maksvet/F2D-RC-shutoff/README.md

# F2D-RC-shutoff
Control line combat F2D RC shutoff
2.4 shutoff rev 0.00
drive the input to an LP4 module to use in F2D shutoff on demand application.
Hold down button during binding.
press button to activate shut off
fail safe will shut off
If the servo motion is backwards then jumper from 8 to 9 and rebind
RF module connects to tx0
