maksvet/F2D-RC-shutoff/Parts-list-transmitter.pdf

# Transmitter/ Передатчик

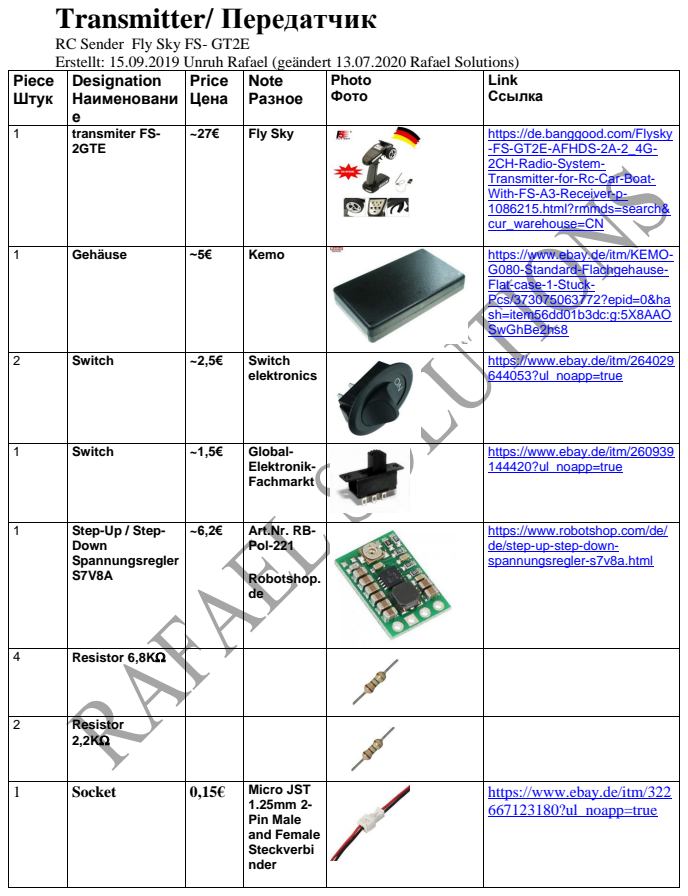
[picture p9: page 1]

RC Sender Fly Sky FS- GT2E
Erstellt: 15.09.2019 Unruh Rafael (geändert 13.07.2020 Rafael Solutions)

Piece Штук | Designation Наименовани е | Price Цена | Note Разное | Photo Фото | Link Ссылка

1 | transmiter FS-2GTE | ~27€ | Fly Sky | | https://de.banggood.com/Flysky-FS-GT2E-AFHDS-2A-2_4G-2CH-Radio-System-Transmitter-for-Rc-Car-Boat-With-FS-A3-Receiver-p-1086215.html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 (https://de.banggood.com/Flysky-FS-GT2E-AFHDS-2A-2_4G-2CH-Radio-System-Transmitter-for-Rc-Car-Boat-With-FS-A3-Receiver-p-1086215.html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)

1 | Gehäuse | ~5€ | Kemo | | https://www.ebay.de/itm/KEMO-G080-Standard-Flachgehause-Flat-case-1-Stuck-Pcs/373075063772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 SwGhBe2hs8 (https://www.ebay.de/itm/KEMO-G080-Standard-Flachgehause-Flat-case-1-Stuck-Pcs/373075063772?epid=0)

2 | Switch | ~2,5€ | Switch elektronics | | https://www.ebay.de/itm/264029644053?ul_noapp=true (https://www.ebay.de/itm/264029644053?ul_noapp=true)

1 | Switch | ~1,5€ | Global-Elektronik-Fachmarkt | | https://www.ebay.de/itm/260939144420?ul_noapp=true (https://www.ebay.de/itm/260939144420?ul_noapp=true)

1 | Step-Up / Step-Down Spannungsregler S7V8A | ~6,2€ | Art.Nr. RB-Pol-221 Robotshop. de | | https://www.robotshop.com/de/de/step-up-step-down-spannungsregler-s7v8a.html (https://www.robotshop.com/de/de/step-up-step-down-spannungsregler-s7v8a.html)

4 | Resistor 6,8KΩ

2 | Resistor 2,2KΩ

1 | Socket | 0,15€ | Micro JST 1.25mm 2-Pin Male and Female Steckverbi nder | | https://www.ebay.de/itm/322667123180?ul_noapp=true (https://www.ebay.de/itm/322667123180?ul_noapp=true)

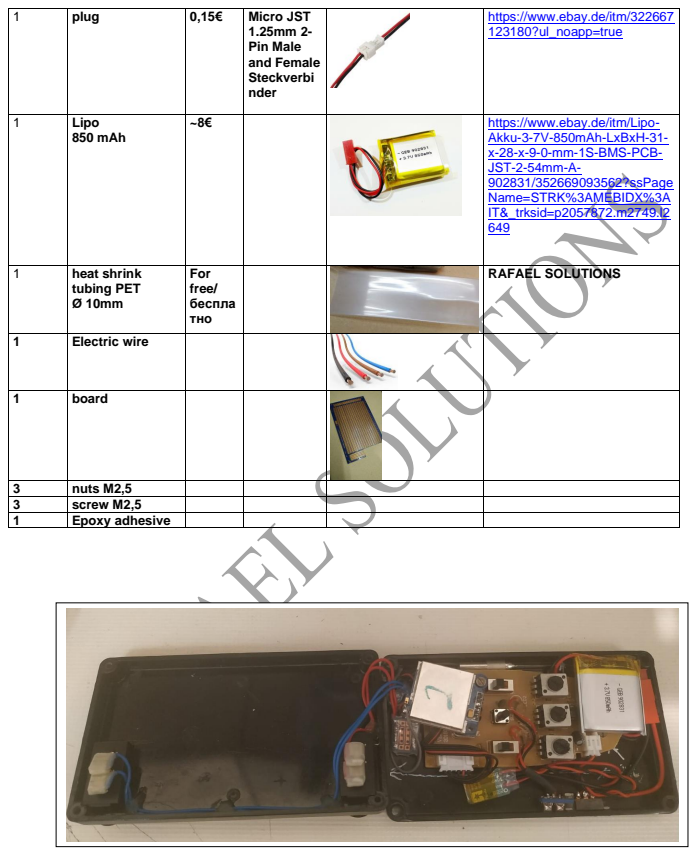
[picture p10: page 2]

1 | plug | 0,15€ | Micro JST 1.25mm 2-Pin Male and Female Steckverbi nder | https://www.ebay.de/itm/322667123180?ul_noapp=true (https://www.ebay.de/itm/322667123180?ul_noapp=true)

1 | Lipo 850 mAh | ~8€ | | https://www.ebay.de/itm/Lipo-Akku-3-7V-850mAh-LxBxH-31-x-28-x-9-0-mm-1S-BMS-PCB-JST-2-54mm-A-902831/352669093562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 649 (https://www.ebay.de/itm/Lipo-Akku-3-7V-850mAh-LxBxH-31-x-28-x-9-0-mm-1S-BMS-PCB-JST-2-54mm-A-902831/352669093562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)

1 | heat shrink tubing PET Ø 10mm | For free/ беспла тно | | RAFAEL SOLUTIONS

1 Electric wire

1 board

3 nuts M2,5
3 screw M2,5
1 Epoxy adhesive

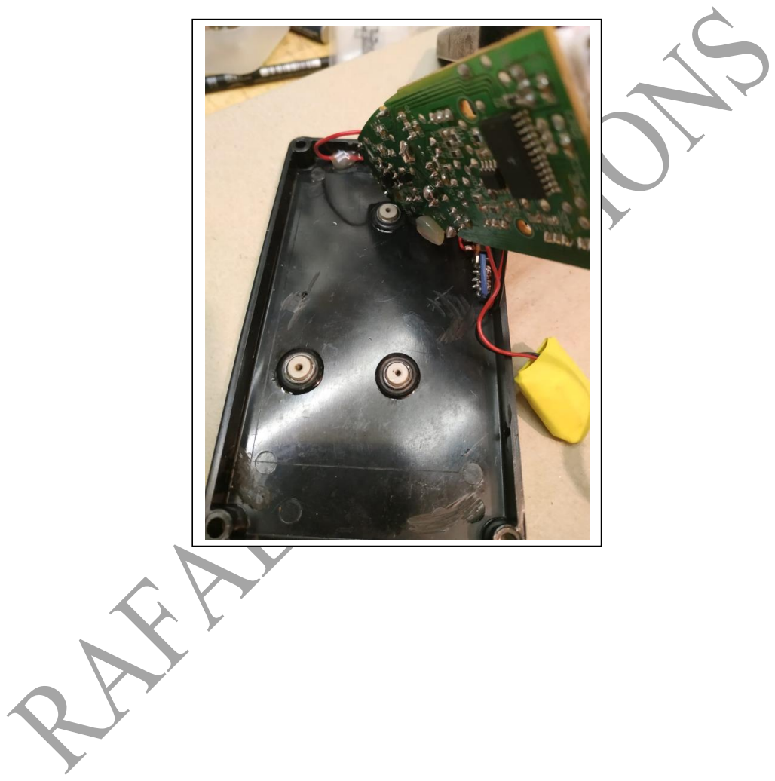
[picture p11: page 3]

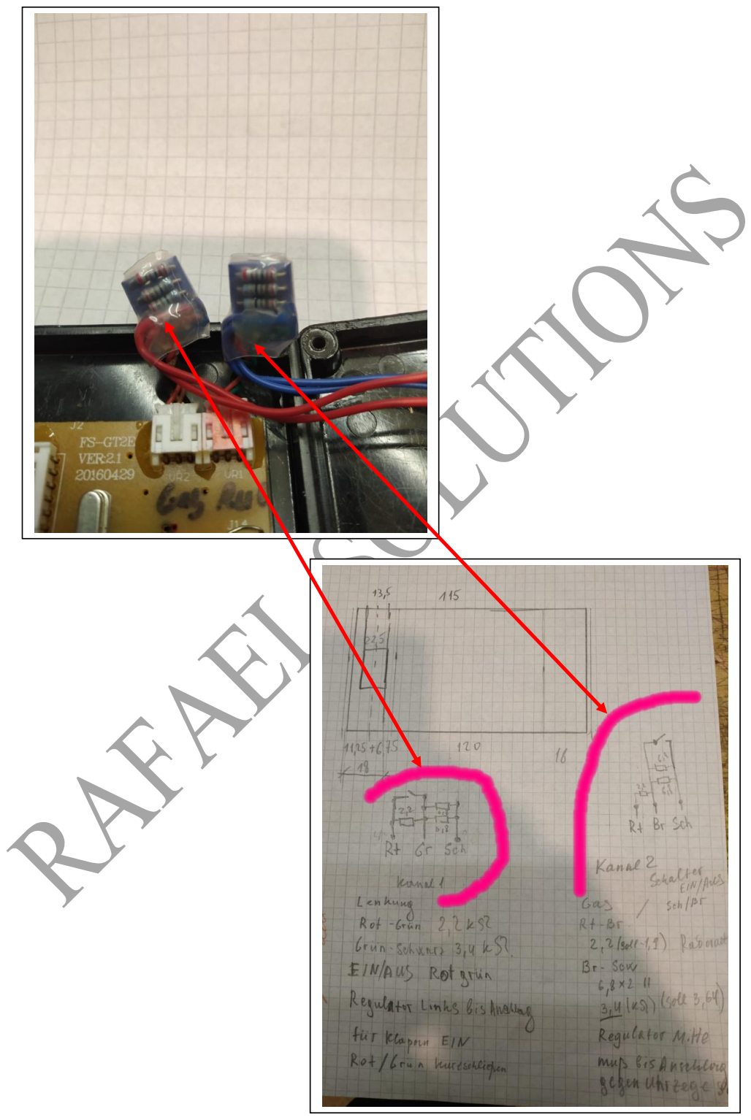
[picture p12: page 4]

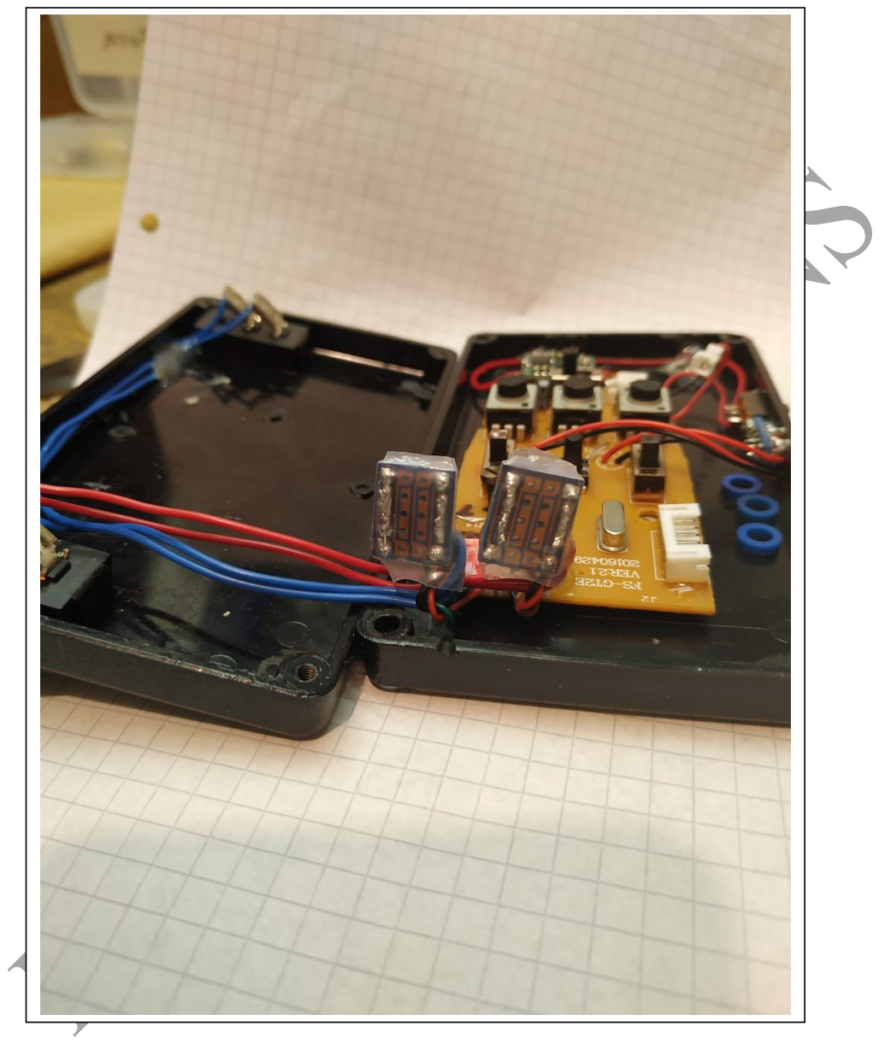
[picture p13: page 5]

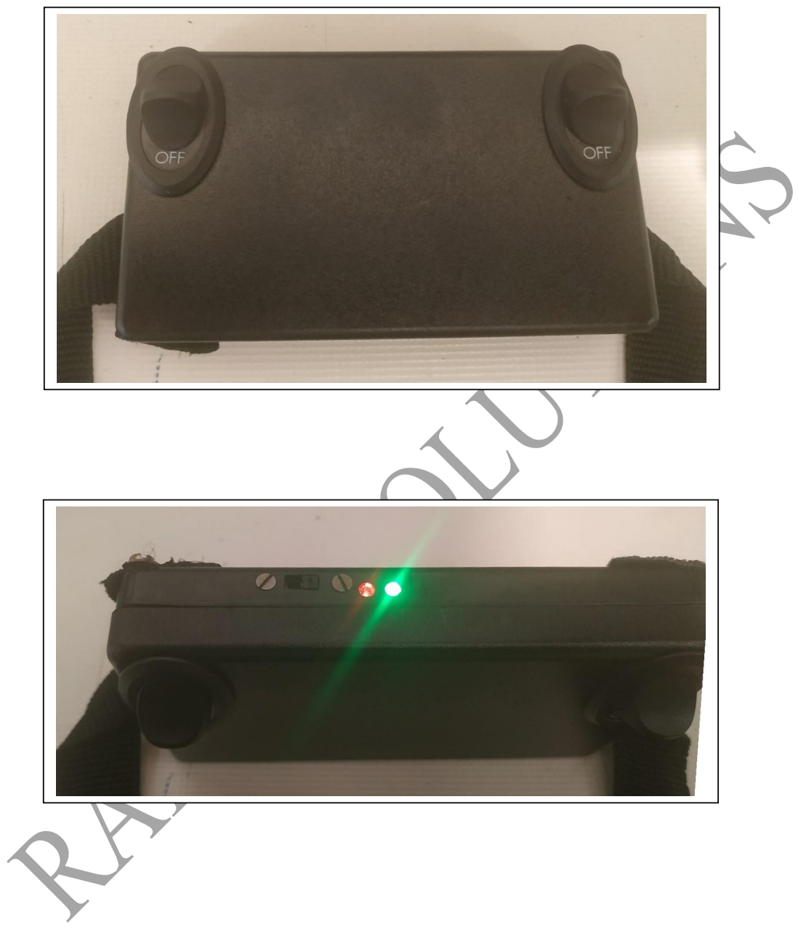
[picture p14: page 6]
