maksvet/F2D-RC-shutoff/valve.pdf

# Valve/ Клапан

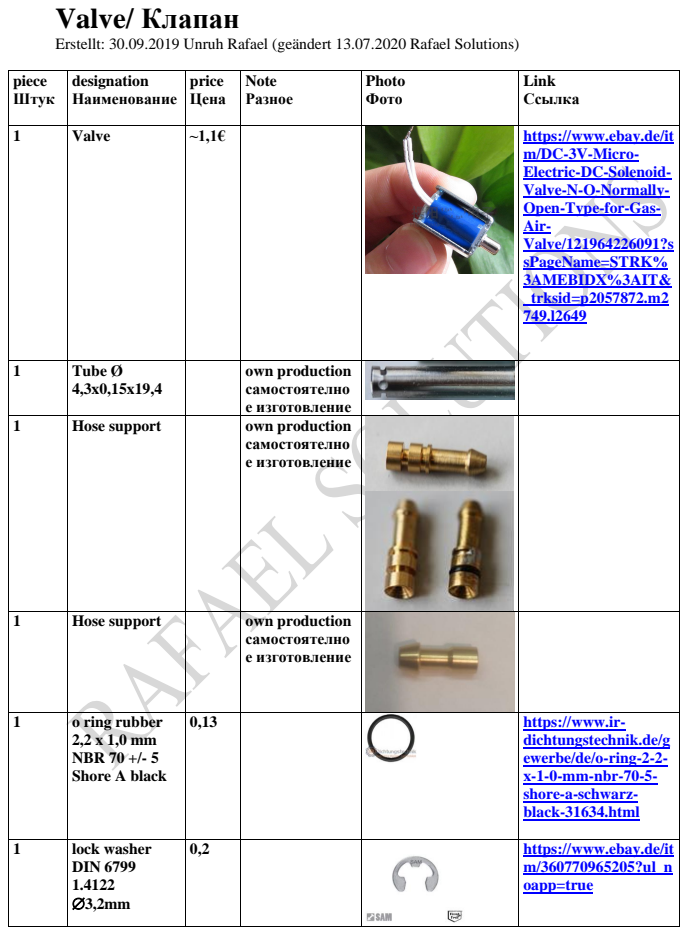
[picture p15: page 1]

Erstellt: 30.09.2019 Unruh Rafael (geändert 13.07.2020 Rafael Solutions)

piece Штук | designation Наименование | price Цена | Note Разное | Photo Фото | Link Ссылка

1 | Valve | ~1,1€ | | | https://www.ebay.de/itm/DC-3V-Micro-Electric-DC-Solenoid-Valve-N-O-Normally-Open-Type-for-Gas-Air-Valve/121964226091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 749.l2649 (https://www.ebay.de/itm/DC-3V-Micro-Electric-DC-Solenoid-Valve-N-O-Normally-Open-Type-for-Gas-Air-Valve/121964226091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)

1 Tube Ø | 4,3x0,15x19,4 | | own production самостоятелно е изготовление

1 | Hose support | | own production самостоятелно е изготовление

1 o ring rubber | 2,2 x 1,0 mm NBR 70 +/- 5 Shore A black | 0,13 | | | https://www.ir-dichtungstechnik.de/gewerbe/de/o-ring-2-2-x-1-0-mm-nbr-70-5-shore-a-schwarz-black-31634.html (https://www.ir-dichtungstechnik.de/gewerbe/de/o-ring-2-2-x-1-0-mm-nbr-70-5-shore-a-schwarz-black-31634.html)

1 lock washer | DIN 6799 1.4122 ∅3,2mm | 0,2 | | | https://www.ebay.de/itm/360770965205?ul_noapp=true (https://www.ebay.de/itm/360770965205?ul_noapp=true)

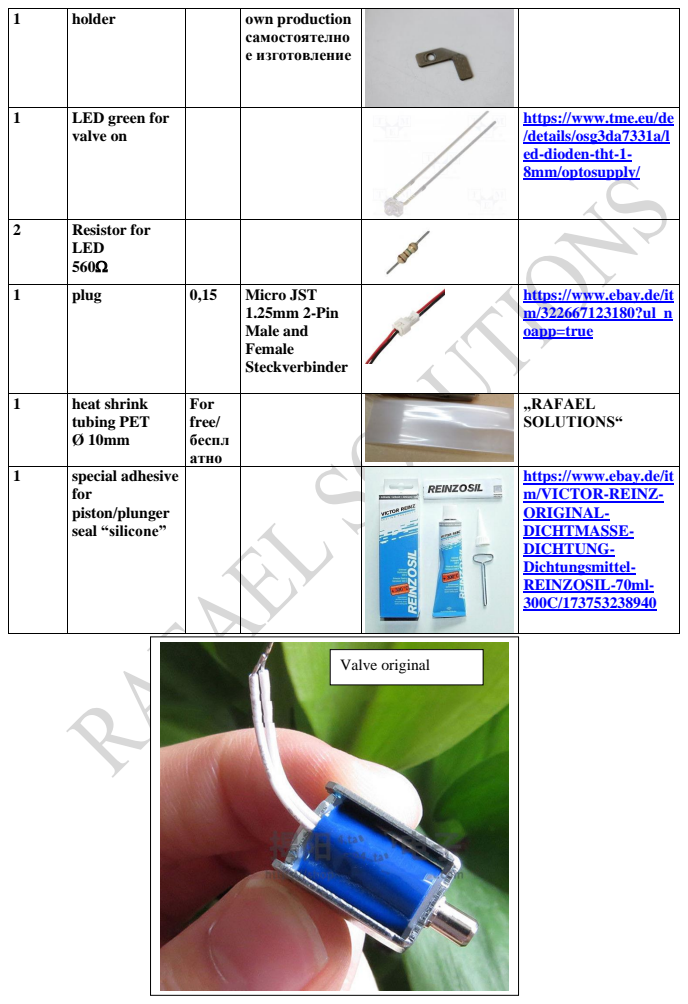
[picture p16: page 2]
Valve original

1 | holder | | own production самостоятелно е изготовление

1 LED green for | valve on | | | https://www.tme.eu/de/details/osg3da7331a/l ed-dioden-tht-1-8mm/optosupply/ (https://www.tme.eu/de/details/osg3da7331a/led-dioden-tht-1-8mm/optosupply/)

2 Resistor for | LED 560Ω

1 | plug | 0,15 | Micro JST 1.25mm 2-Pin Male and Female Steckverbinder | https://www.ebay.de/itm/322667123180?ul_noapp=true (https://www.ebay.de/itm/322667123180?ul_noapp=true)

1 heat shrink | tubing PET Ø 10mm | For free/ беспл атно | | „RAFAEL SOLUTIONS“

1 special adhesive | for piston/plunger seal “silicone” | | | https://www.ebay.de/itm/VICTOR-REINZ-ORIGINAL-DICHTMASSE-DICHTUNG-Dichtungsmittel-REINZOSIL-70ml-300C/173753238940 (https://www.ebay.de/itm/VICTOR-REINZ-ORIGINAL-DICHTMASSE-DICHTUNG-Dichtungsmittel-REINZOSIL-70ml-300C/173753238940)

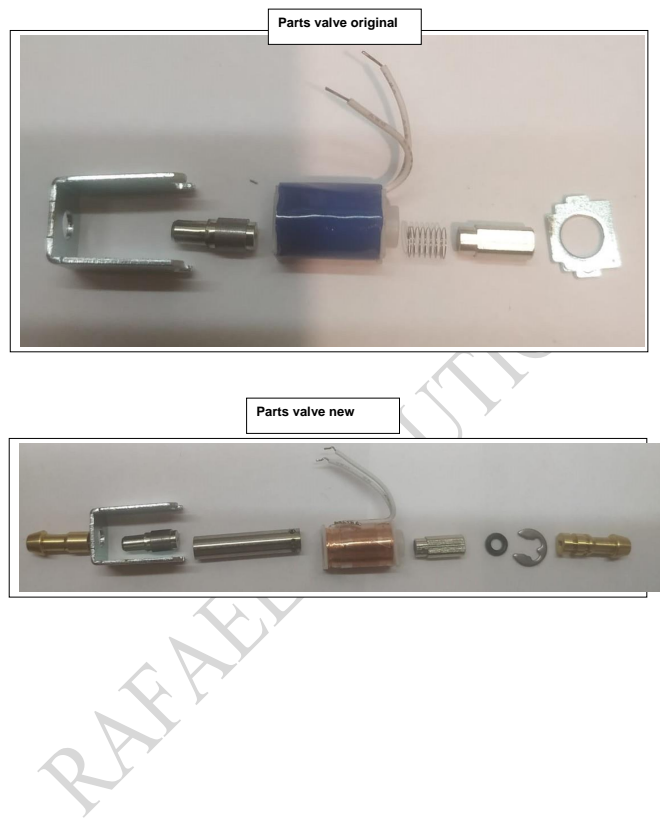
[picture p17: page 3]

Parts valve original

Parts valve new

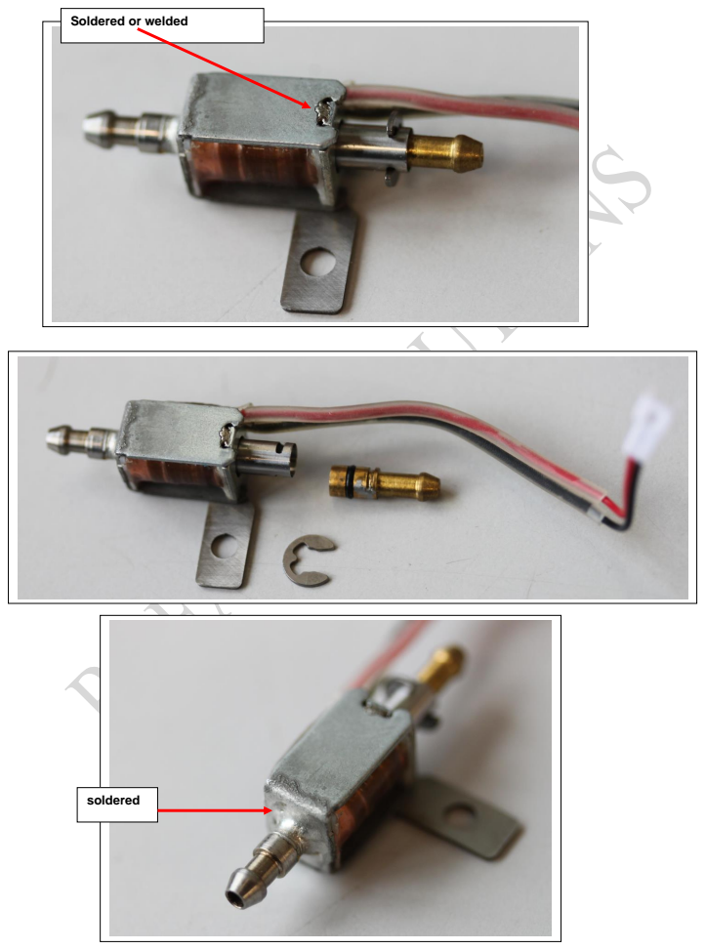
[picture p18: page 4]
soldered

Soldered or welded

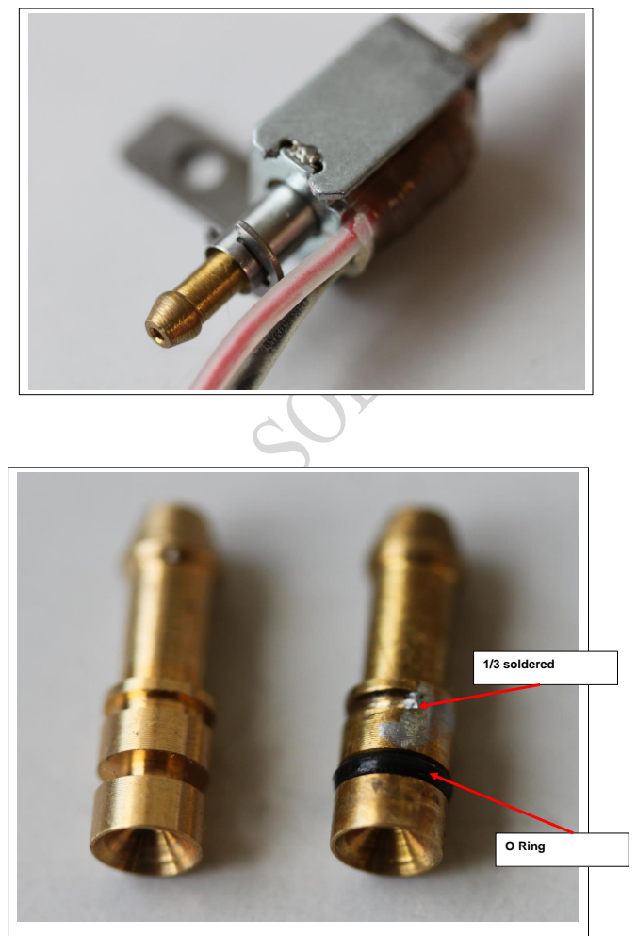
[picture p19: page 5]
O Ring; 1/3 soldered

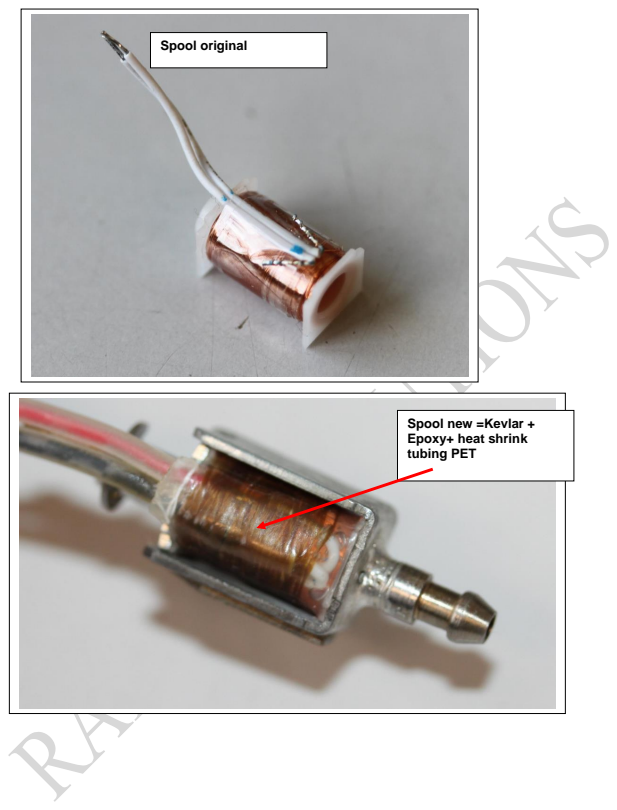
[picture p20: page 6]
Spool original

Spool new =Kevlar +
Epoxy+ heat shrink
tubing PET

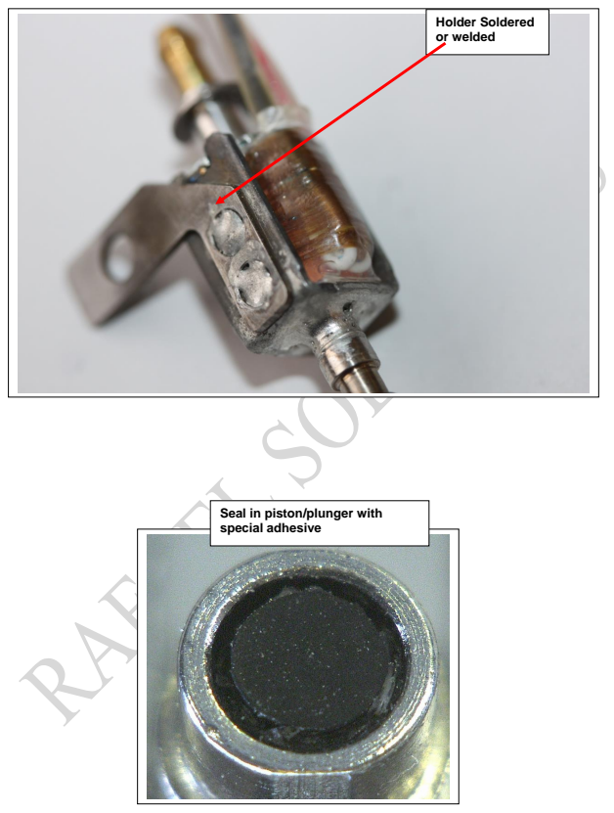
[picture p21: page 7]
Plus; Holder Soldered or welded

Seal in piston/plunger with
special adhesive

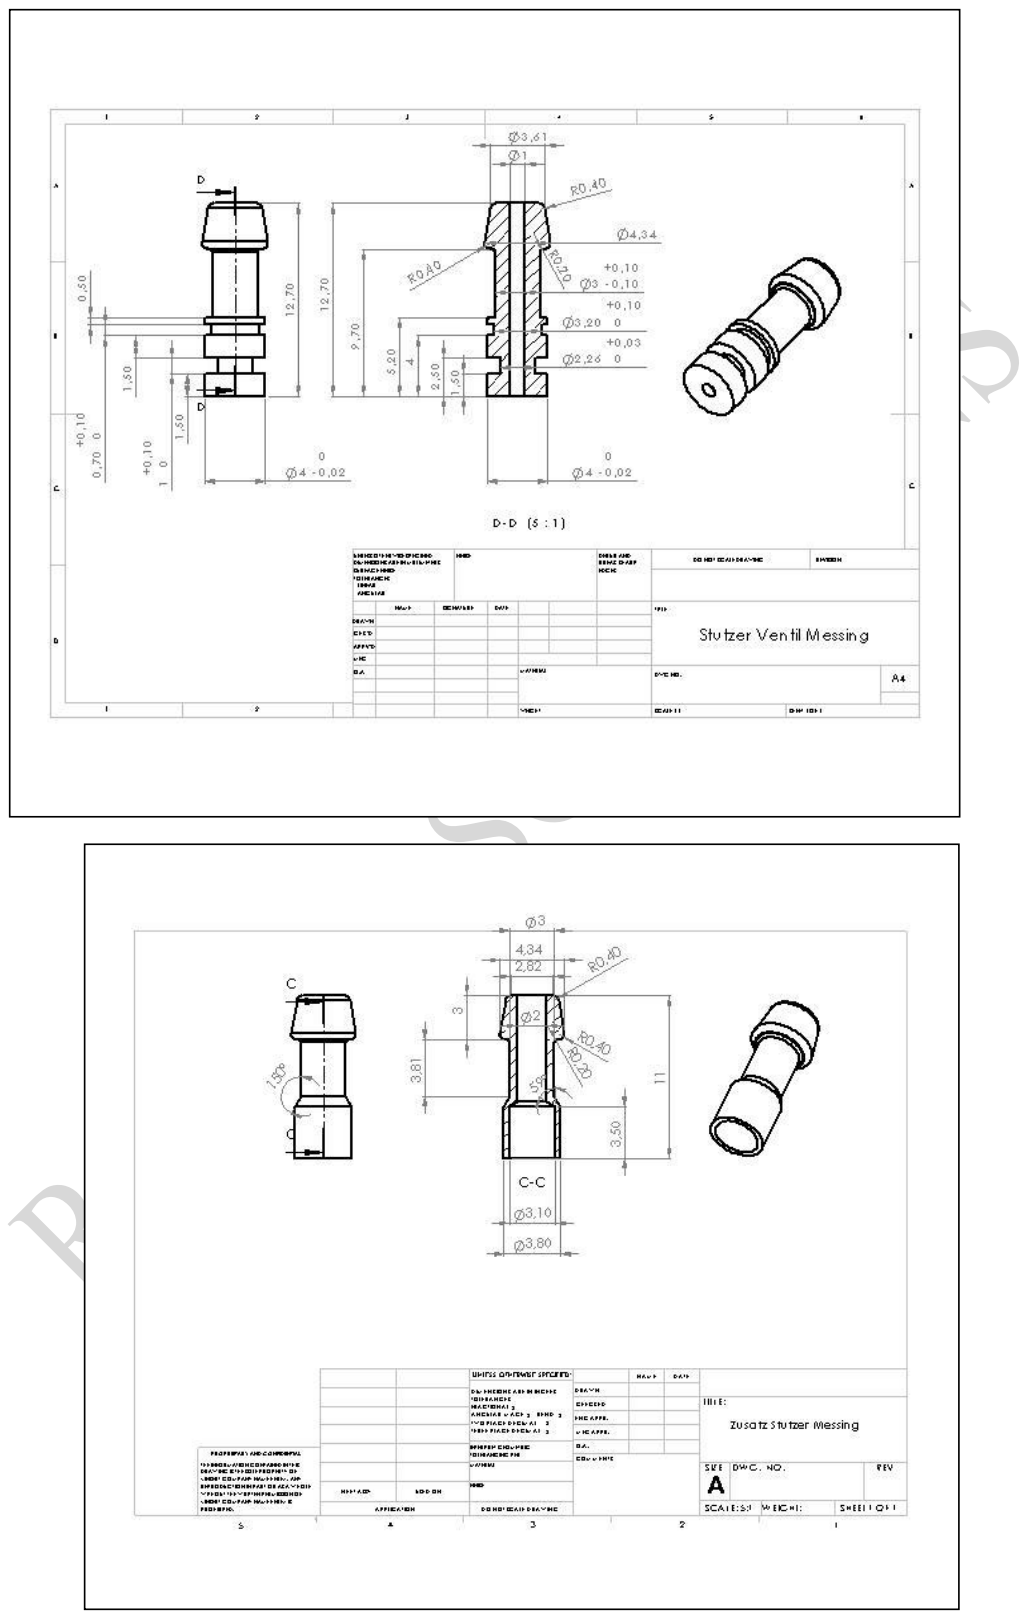
[picture p22: page 8]

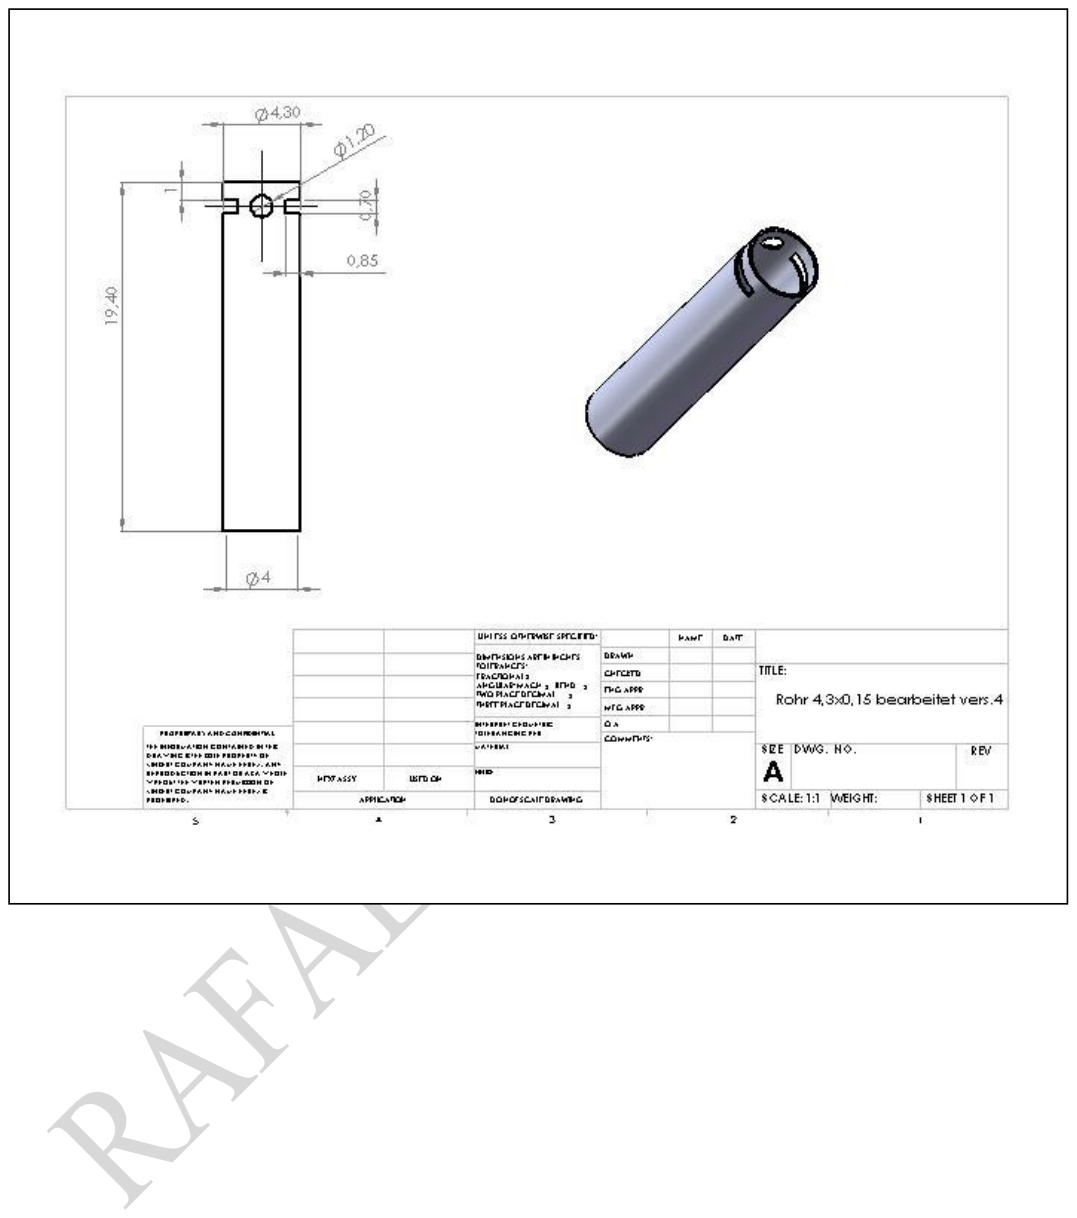
[picture p23: page 9]
